pierregoge/Plancha-ASV/README.md

# Plancha-ASV
All you need to create your ASV with acoustic tracking, bathymetric and photogrammetry features 

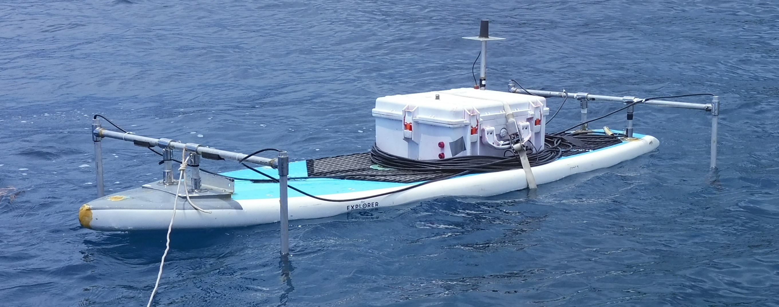
[picture p1: Photos/ASV_plancha_acoustic_mode.jpg]
Plancha_ASV_illustration
