pierregoge/Plancha-ASV/Diagrams/electrical_diagram.png

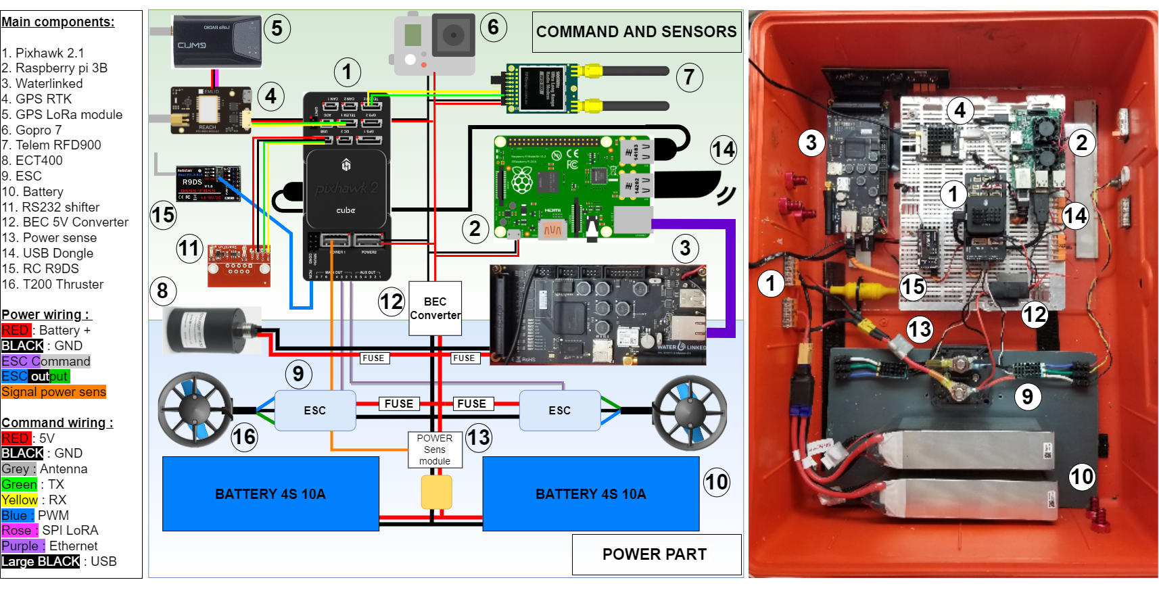
Diagrams/electrical_diagram.png
