pierregoge/Plancha-ASV/Diagrams/network_diagram.png

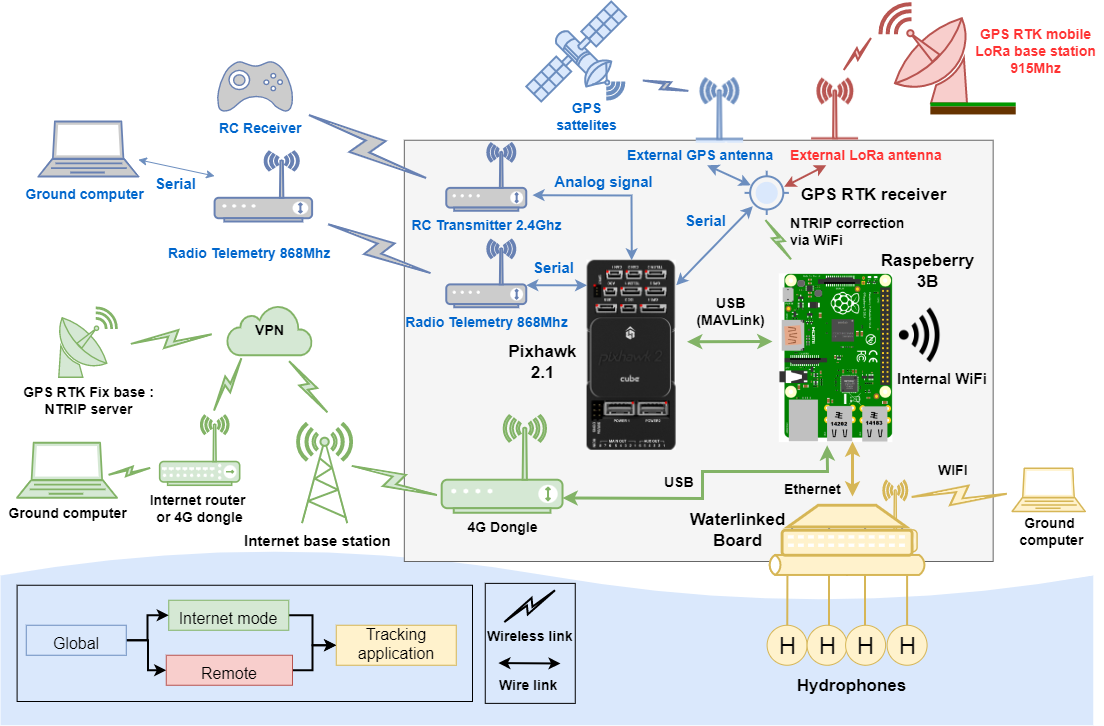
Diagrams/network_diagram.png
