pierregoge/Plancha-ASV/Photos/Plancha_ASV_illustration.png

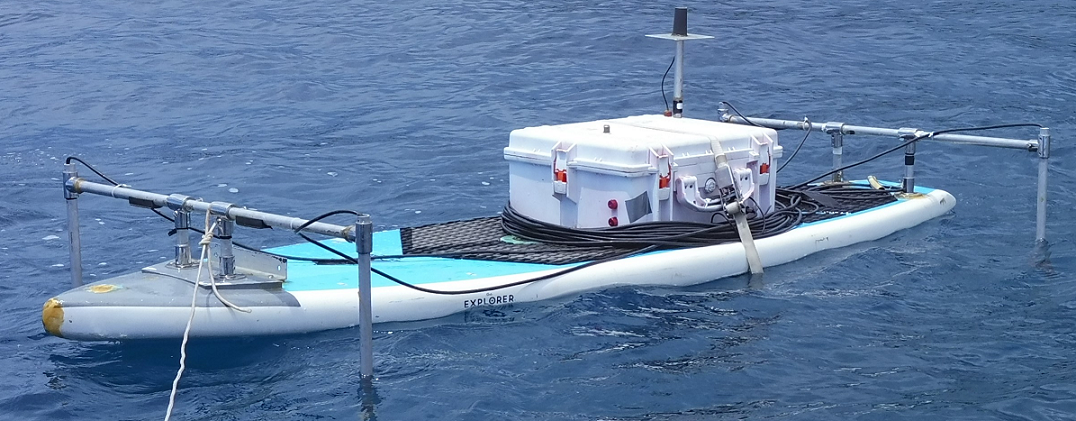
Photos/Plancha_ASV_illustration.png
