pierregoge/Plancha-ASV/Documents/4_BOM.xlsx

Designator | Component | Number | Cost per unit - currency | Total cost - currency | Source of materials
Autopilot | PixHawk 2.1 | 1 | 238.00 € | 238.00 € | https://hexadrone.fr/cube-carrier-board/1724-pixhawk-21-hex-0094393516606.html | GLOBAL
Cable | Pixhawk2.1 Cable Set | 1 | $15.00 | $15.00 | https://www.robotshop.com/en/pixhawk21-cable-set.html
GNSS RTK | Reach M2 | 1 | $499.00 | $499.00 | https://store.emlid.com/product/reachm2/
RC transmitter | RadioLink AT9S PRO 2.4GHz | 1 | $129.99 | $129.99 | https://www.robotshop.com/en/radiolink-at9s-pro-24ghz-12ch-transmitter-w--r9ds-10ch-receiver.html
Power sense | Power Sense Module | 1 | $31.00 | $31.00 | https://bluerobotics.com/store/comm-control-power/elec-packages/psm-asm-r2-rp/
Voltage converter | 5V 6A Power Supply | 3 | $22.00 | $66.00 | https://bluerobotics.com/store/comm-control-power/elec-packages/bec-5v6a-r1/
Batteries | Tattu 14.8V 25C 4S 10000mAh | 2 | $150.00 | $300.00 | https://hexadrone.fr/4s-148v/3219-batterie-10000mah-148v-30c-4s-tattu-6928493335475.html
Thrusters | T200 | 2 | $179.00 | $358.00 | https://bluerobotics.com/store/thrusters/t100-t200-thrusters/t200-thruster-r2-rp/
Speed controllers | Basic ESC | 2 | $27.00 | $54.00 | https://bluerobotics.com/store/thrusters/speed-controllers/besc30-r3/
Thruster connectors | Cobalt Series Bulkhead Connector | 2 | $42.00 | $84.00 | https://www.bluetrailengineering.com/product-page/cobalt-series-bulkhead-connector
Thruster connectors | Cobalt Series Cable Termination Kit | 2 | $25.00 | $50.00 | https://www.bluetrailengineering.com/product-page/cable-termination-kit
Surf Board | Size 8", 80L | 1 | $200.00 | $200.00 | Local reseller | Mecanichal
Thruster support | Thruster support | 1 | $150.00 | $150.00 | Local welder
Echosounder | Echologger ETC400 | 1 | $3850.00 | $3850.00 | https://www.echologger.com/products/single-frequency-echosounder-deep | Survey
Converter RS232 | SparkFun RS232 Shifter SMD | 1 | $10.95 | $10.95 | https://www.sparkfun.com/products/8780
Camera | Gopro 7 | 1 | $349.00 | $349.00 | https://www.fnac.com/GoPro-Hero7-Black-WiFi-et-Bluetooth/a12803259/w-4
SD card | SANDISK 128GO | 1 | $54.00 | $54.00 | https://www.lacameraembarquee.fr/cartes-memoires-gopro/7507-sandisk-128go-extreme-pro-microsdxc-619659169817.html
Waterproof case | Suptig Waterproof Case | 1 | $18.99 | $18.99 | https://www.amazon.com/Suptig-remplacement-protection-utilisation-r%C3%A9sistant/dp/B0774QGG1G
Echosounder holder | Echosounder holder | 1 | $20.00 | $20.00 | Printed part
Acoustic receiver | WaterLinked Underwater GPS | 1 | $2200.00 | $2200.00 | https://store.waterlinked.com/product/underwater-gps-g2/ | Tracking
Acoustic beacon | Waterlinked locator U1 | 1 | $1500.00 | $1500.00 | https://store.waterlinked.com/product/locator-u1/
Aluminum holding arm | Aluminum holding arm | 1 | $200.00 | $200.00 | Local welder
Companion board | Raspberry pi 3B+ | 1 | $38.39 | $38.39 | https://www.robotshop.com/en/raspberry-pi-3-b-computer-board.html | Internet mode
Internet dongle | Huawei E3372 | 1 | $50.00 | $50.00 | https://www.amazon.fr/Huawei-Unlocked-E3372-Mbps-Dongle/dp/B07BNRZH3T
GNSS RTK base | Elmid reach RS2 | 1 | $2199.00 | $2199.00 | https://store.emlid.com/product/reachrs2/ | Remote mode
GNSS radio communication | Elmid reach RS2 | 1 | $118.00 | $118.00 | https://store.emlid.com/product/reach-m-lora-radio/
Stainless steel straps | Stainless steel straps | 2 | $32.00 | $64.00 | Local reseller | Other
Heat sink | Dual Cooling Fans Kit | 2 | $6.50 | $13.00 | https://www.robotshop.com/en/raspberry-pi-dual-cooling-fans-kit-compatible-w-raspberry-pi-3b3b4b.html
USB Cable | Flexible USB | 1 | $10.00 | $10.00 | https://www.adafruit.com/product/3560 / https://www.adafruit.com/product/4109 / https://www.adafruit.com/product/4105
Ribbon Cable | 20 cm Ribbon Cable | 1 | $1.95 | $1.95 | https://www.adafruit.com/product/3561
Straight Type A Plug | Straight Type A Plug | 1 | $4.95 | $4.95 | https://www.adafruit.com/product/4109
Right Angle Micro B Plug Down | Right Angle Micro B Plug Down | 1 | $4.95 | $4.95 | https://www.adafruit.com/product/4105
Standoff Mounting Kit | M3 x 20mm Hex | 3 | $2.90 | $8.70 | https://www.robotshop.com/en/m3-20mm-hex-standoff-mounting-kit-10pk.html
Standoff Mounting Kit | M3 x 10mm Hex | 3 | $2.90 | $8.70 | https://www.robotshop.com/en/m3-10mm-hex-standoff-mounting-kit-10pk.html
Standoff Mounting Kit | M3 x 30mm Hex | 3 | $2.90 | $8.70 | https://www.robotshop.com/en/m3-x-30mm-hexagonal-standoffs-kit-10pk.html
Cable Penetrator | M10 Cable Penetrator for 8mm Cable | 5 | $5.00 | $25.00 | https://bluerobotics.com/store/cables-connectors/penetrators/penetrator-vp/
Cable Penetrator | M10 Cable Penetrator for 6mm Cable | 5 | $4.00 | $20.00 | https://bluerobotics.com/store/cables-connectors/penetrators/penetrator-vp/
Batteries | Tattu 14.8V 25C 4S 10000mAh | 2 | $149.00 | $298.00 | https://www.genstattu.com/tattu-10000mah-14-8v-25c-4s1p-lipo-battery-pack-without-plug.html
Grid for electrical circuit | No ref | 1 | $15.00 | $15.00 | Local resseller
Busbar | MiniBus Busbar | 1 | $15.00 | $15.00 | https://www.svb24.com/en/blue-sea-minibus-busbar.html
Fuse Holder (For SBL) | ATO In-Line Fuse Holder | 1 | $15.00 | $15.00 | https://www.svb-marine.fr/fr/blue-sea-porte-fusible-plat-ato.html
Fuse Holder | Sealed fuse holder for a tab fuseVdm | 2 | $15.00 | $30.00 | https://www.nootica.fr/porte-fusible-etanche-vdm-pour-fusible-a-languette.html
 |  |  | Total (no survey, no tracking) | $2761.33
 |  |  | Total (no tracking) | $7064.27
 |  |  | Total (tracking, no survey) | $6661.33
 |  |  | Remote | $2317.00
 |  |  | TOTAL | $13266.27
