pierregoge/Plancha-ASV/Sotfware/Photogrammetry/Spacing_between_transect_calculator.xlsx

Calcul espacement transects USV - photogrammétrie de récif |  |  |  | liste angles ouverture
Note de calcul pour établir l'espacement entre transects de l'USV afin d'obtenir un taux de recouvrement suffisant entre photos pour la réalisation d'un modèle photogrammétrique de qualité |  |  |  | super wide | 170
Inputs |  |  |  | wide | 130
Designation | Valeur | Unité | Commentaire | linear | 90
Taux de recouvrement | 80% |  | Minimum 70% sans sécurité
Angle ouverture GoPro | 90 | deg | fonction du FOV caméra choisi
Profondeur du site | 5 | m | indiquer la profondeur mini - du capteur au fond marin
Outputs
Designation | Valeur | Unité | Commentaire
Espacement entre transects USV | 2.0 | m
