pierregoge/Plancha-ASV/Mechanical/echosounder_mouting_1.STL

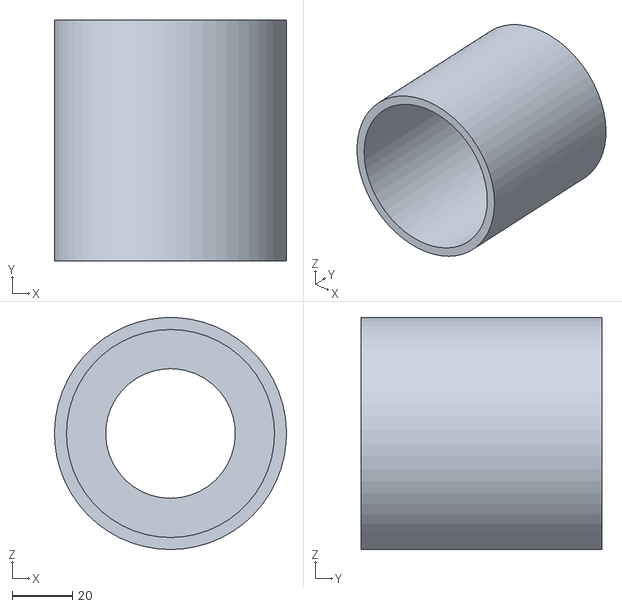
[picture p5: CAD file, 2022-06-03]
Mechanical/echosounder_mouting_1.STL
77.0 x 80.0 x 77.0
