pierregoge/Plancha-ASV/Mechanical/cable_entry.STL

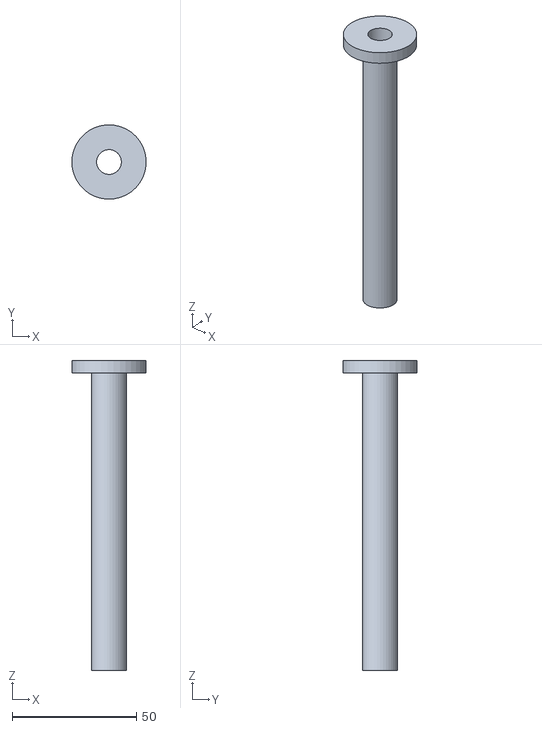
[picture p6: CAD file, 2022-06-03]
Mechanical/cable_entry.STL
30.0 x 30.0 x 125.0
