pierregoge/Plancha-ASV/Mechanical/echosounder_mouting_2.STL

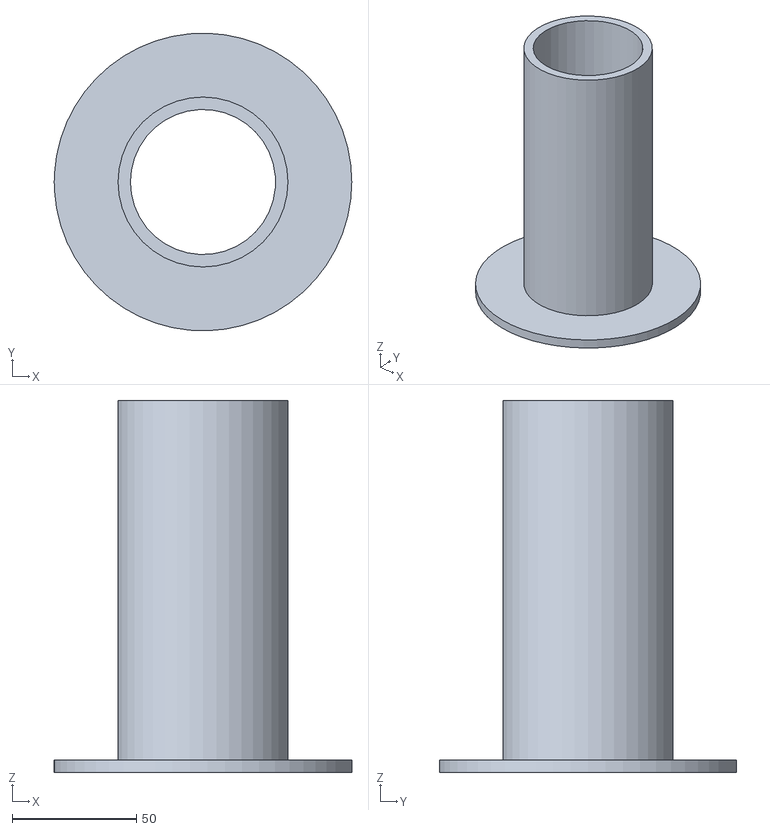
[picture p7: CAD file, 2022-06-03]
Mechanical/echosounder_mouting_2.STL
120.0 x 119.9 x 150.0
