pierregoge/Plancha-ASV/Features_example/test_bathy_europa_09_10_20/bathy/depth_filtered_corr.png

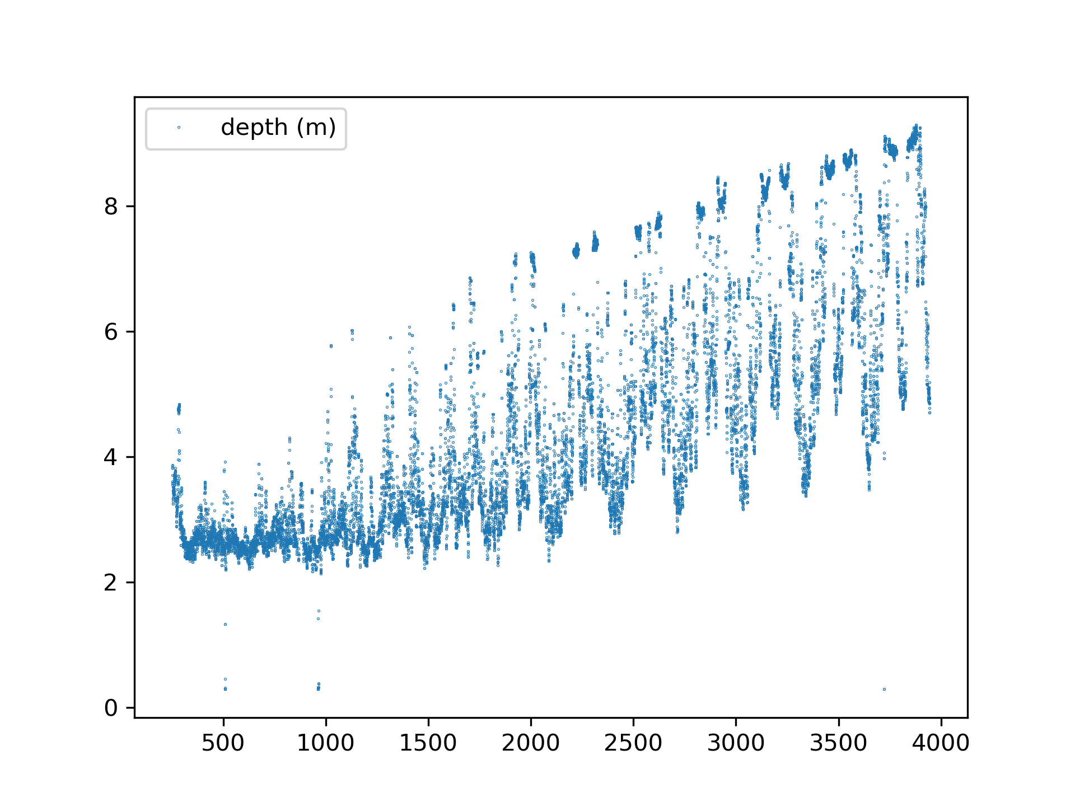
Features_example/test_bathy_europa_09_10_20/bathy/depth_filtered_corr.png
