pierregoge/Plancha-ASV/Features_example/test_bathy_europa_09_10_20/bathy/roll_pitch_filtered.png

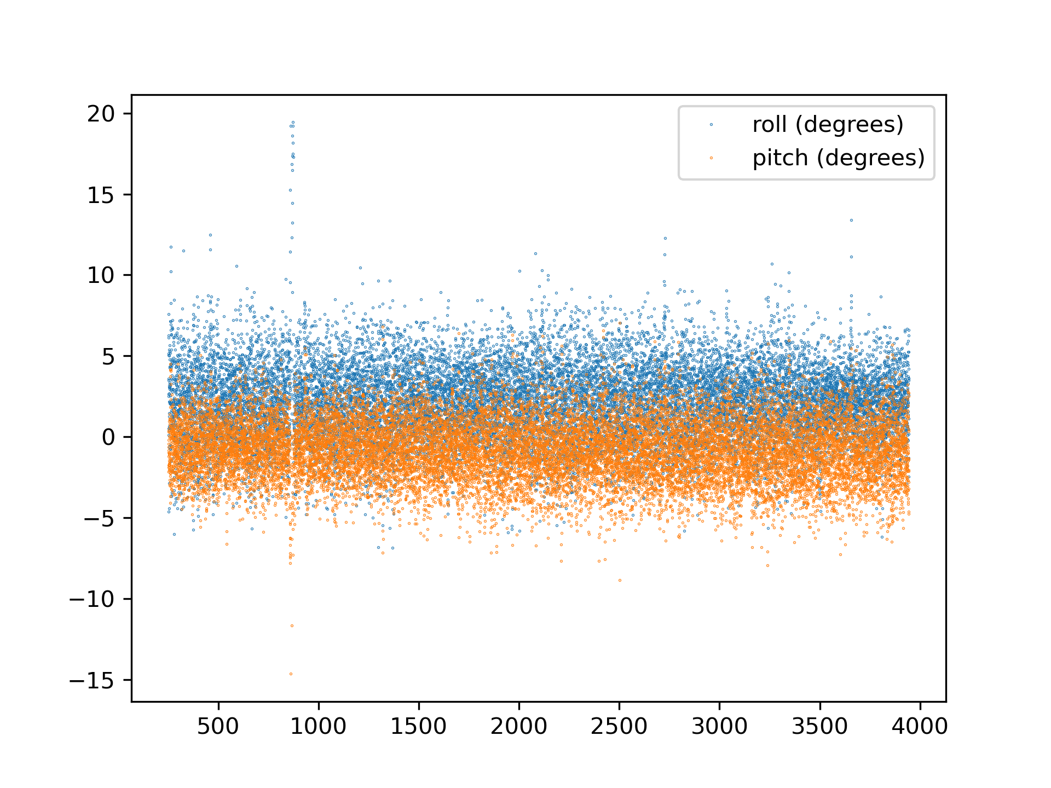
Features_example/test_bathy_europa_09_10_20/bathy/roll_pitch_filtered.png
