pierregoge/Plancha-ASV/Features_example/test_bathy_europa_09_10_20/image/bathy_global_mapper_3.PNG

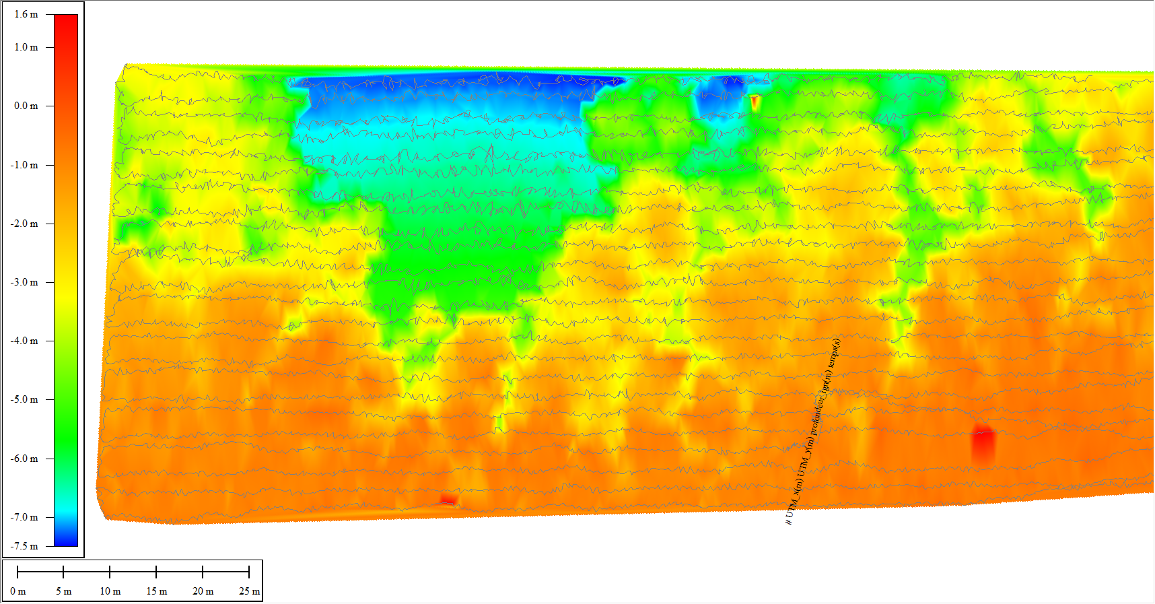
Features_example/test_bathy_europa_09_10_20/image/bathy_global_mapper_3.PNG
