pierregoge/Plancha-ASV/Features_example/test_bathy_europa_09_10_20/image/graph_bathy_europa_2.jpg

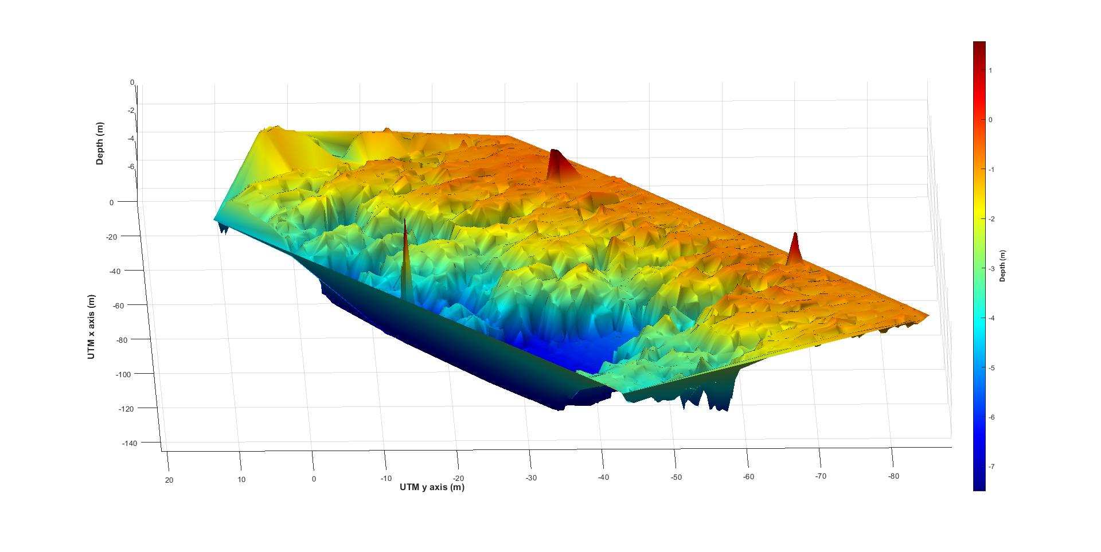
Features_example/test_bathy_europa_09_10_20/image/graph_bathy_europa_2.jpg
