pierregoge/Plancha-ASV/Features_example/test_conso_18_02_22/image/fig_conso_18_02_22.jpg

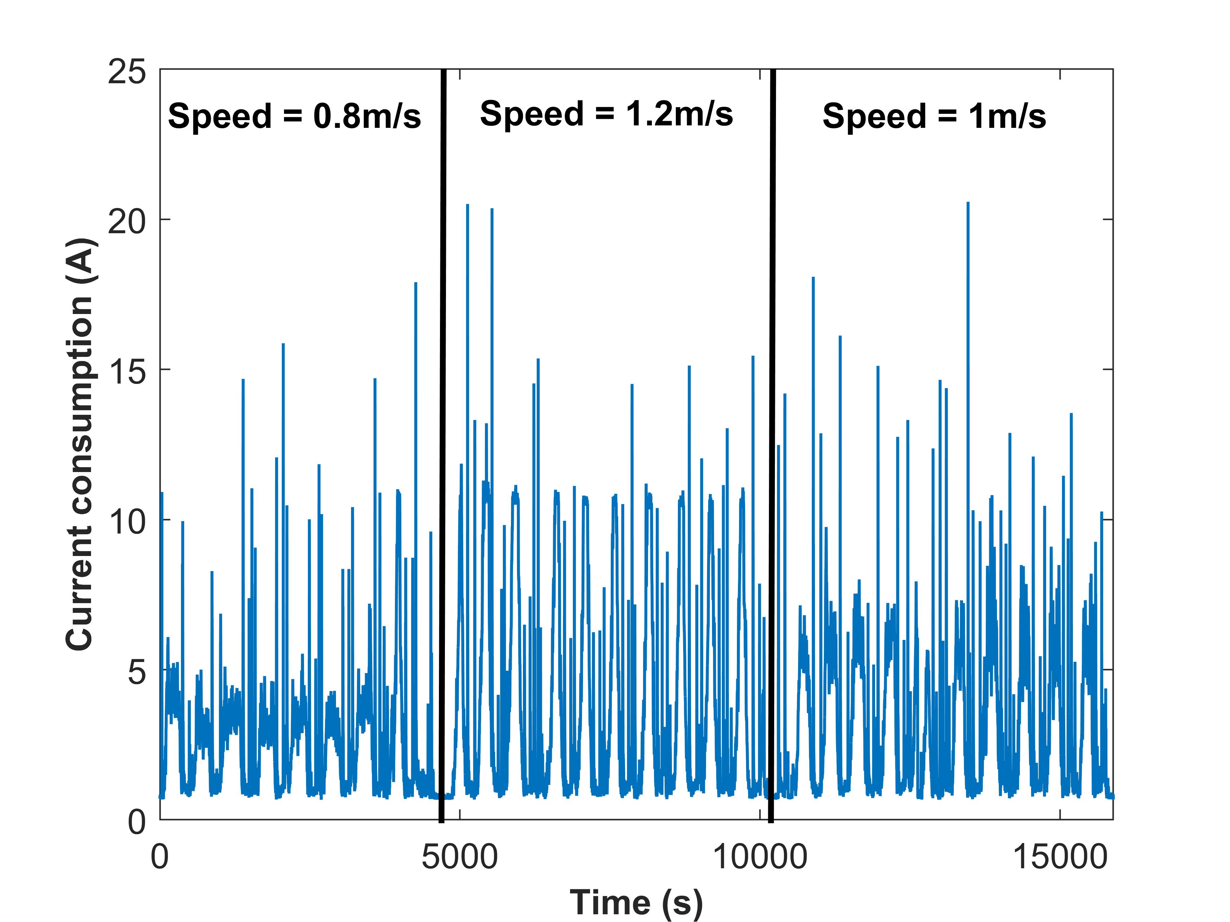
Features_example/test_conso_18_02_22/image/fig_conso_18_02_22.jpg
