pierregoge/Plancha-ASV/Features_example/test_navigation_11_01_22/code/image/asv_current_consumption.jpg

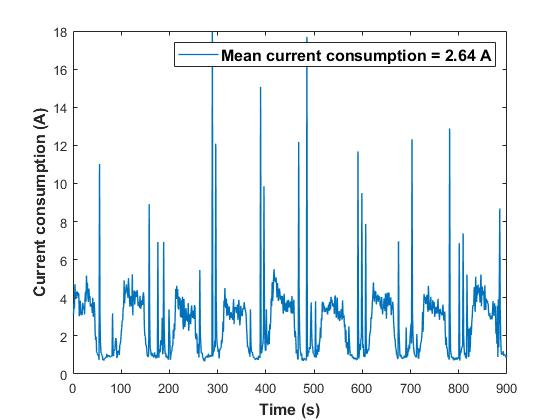
Features_example/test_navigation_11_01_22/code/image/asv_current_consumption.jpg
