pierregoge/Plancha-ASV/Features_example/test_navigation_11_01_22/code/image/asv_wp_trajectory.jpg

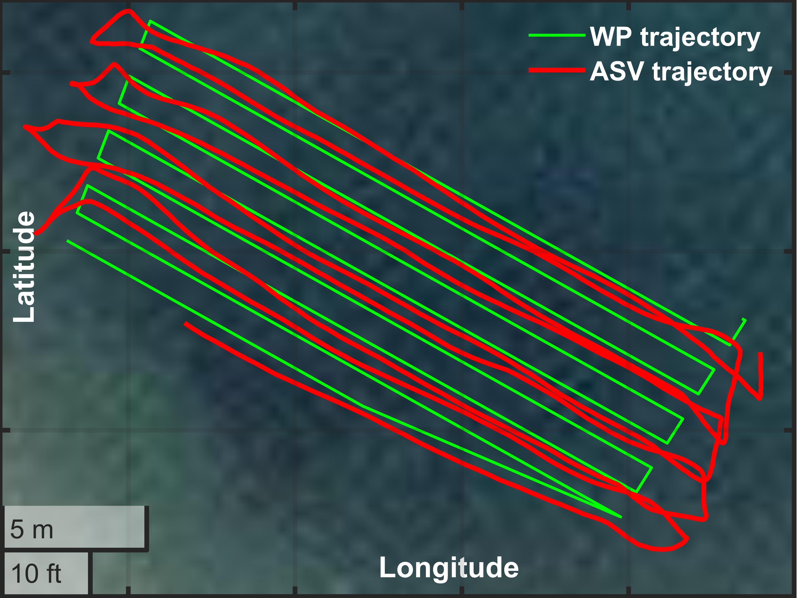
Features_example/test_navigation_11_01_22/code/image/asv_wp_trajectory.jpg
