pierregoge/Plancha-ASV/Features_example/test_navigation_11_01_22/image/screenshot_mission_planner.PNG

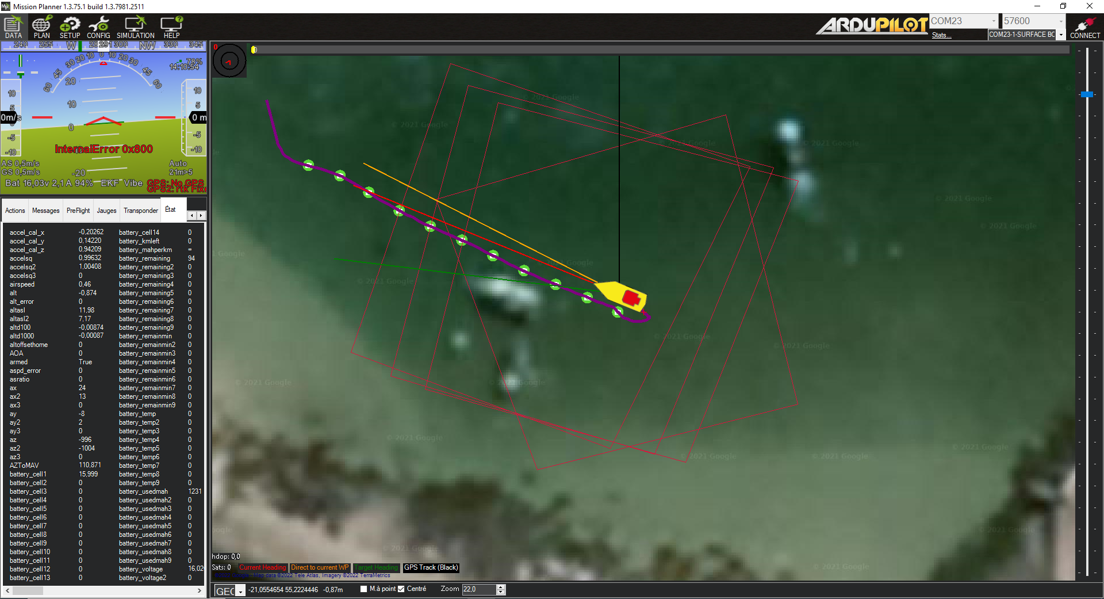
Features_example/test_navigation_11_01_22/image/screenshot_mission_planner.PNG
