pierregoge/Plancha-ASV/Features_example/test_tracking_26_10_21/code/image/geoplot_ASV_diver_trajectories.jpg

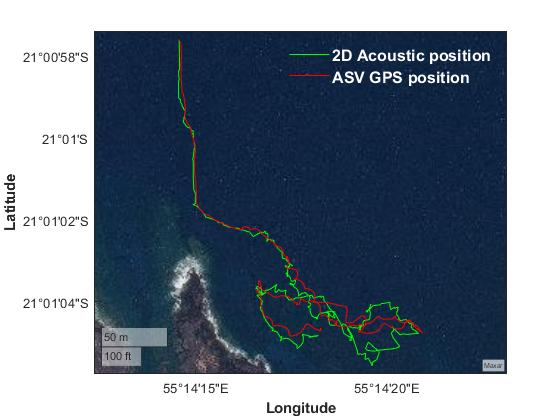
Features_example/test_tracking_26_10_21/code/image/geoplot_ASV_diver_trajectories.jpg
