pierregoge/Plancha-ASV/Features_example/test_tracking_26_10_21/photo/DSCI2090.JPG

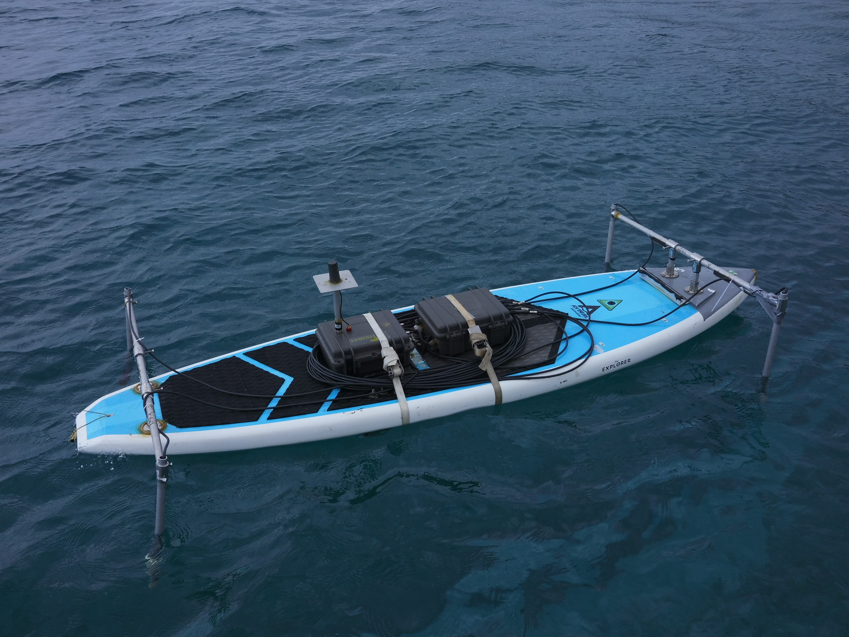
Features_example/test_tracking_26_10_21/photo/DSCI2090.JPG
