pierregoge/Plancha-ASV/Features_example/test_tracking_26_10_21/photo/screen_gopro.PNG

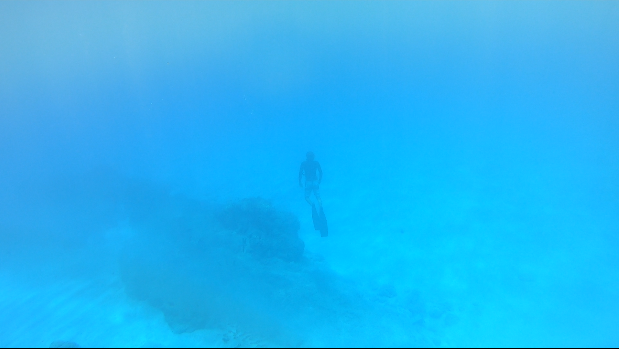
Features_example/test_tracking_26_10_21/photo/screen_gopro.PNG
