pierregoge/Plancha-ASV/Features_example/test_tracking_conso_14_12_21/image/asv_tracking_current_consumption.jpg

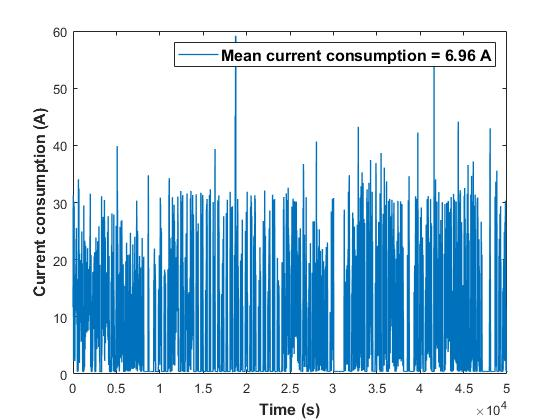
Features_example/test_tracking_conso_14_12_21/image/asv_tracking_current_consumption.jpg
