pierregoge/Plancha-ASV/Mechanical/Thruster_holder.pdf

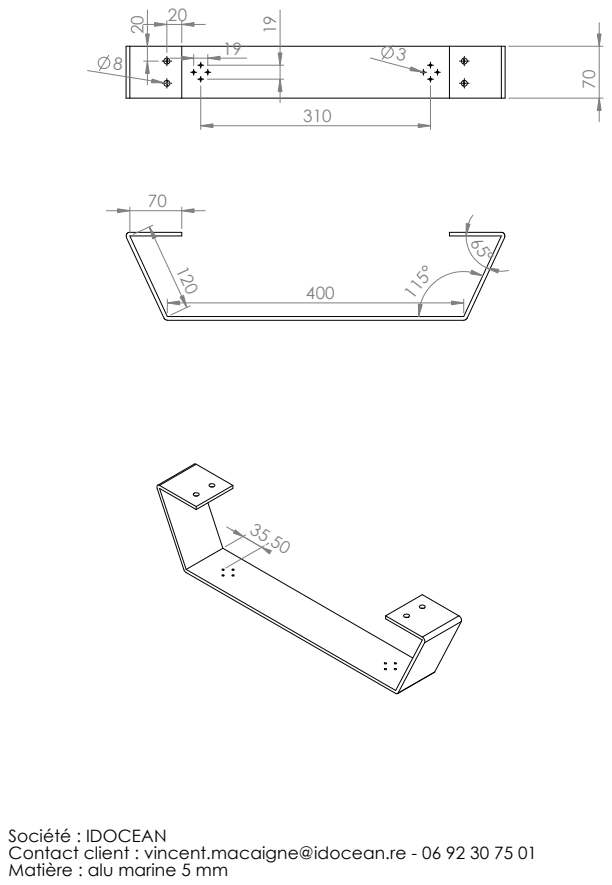
[picture p29: page 1]

Société : IDOCEAN
Contact client : vincent.macaigne@idocean.re - 06 92 30 75 01
Matière : alu marine 5 mm
