pierregoge/Plancha-ASV/(commit log)

2022-06-03 Adding first draw of document
    [4_BOM.xlsx]
2022-06-03 adding document folder
    [4_BOM.xlsx]
2022-06-03 adding mechanical files
    [cable_entry.STL, echosounder_mouting_1.STL, echosounder_mouting_2.STL]
2022-06-03 change name param
    [param_110122.param]
2022-06-03 change name
    [Spacing_between_transect_calculator.xlsx]
